teoful/ArduinoRightLight/Fritzing Schemes/Curtains.jpg

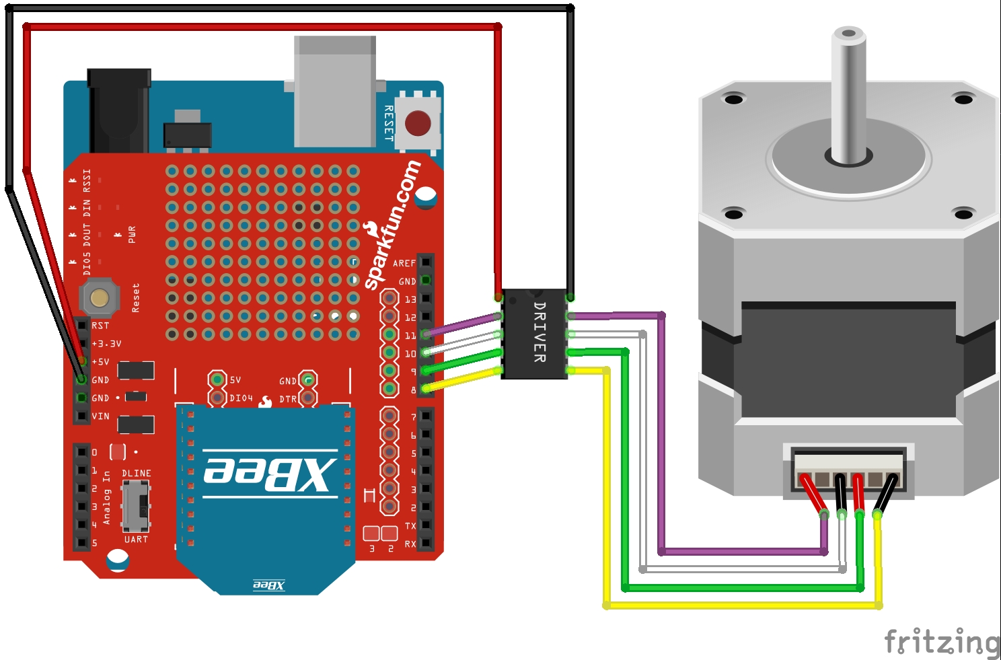
Fritzing Schemes/Curtains.jpg
