teoful/ArduinoRightLight/Fritzing Schemes/External.jpg

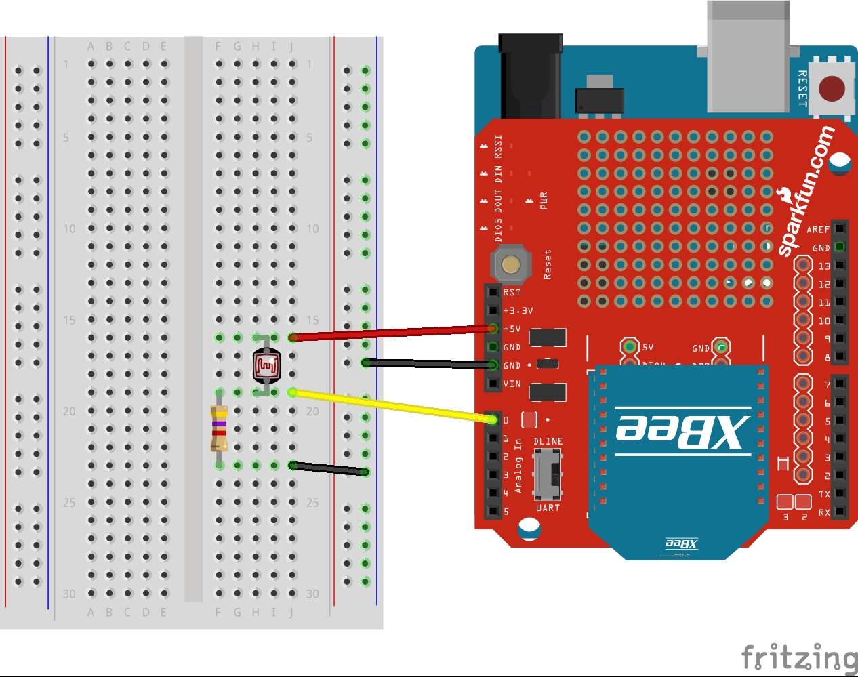
Fritzing Schemes/External.jpg
