teoful/ArduinoRightLight/Fritzing Schemes/Global.jpg

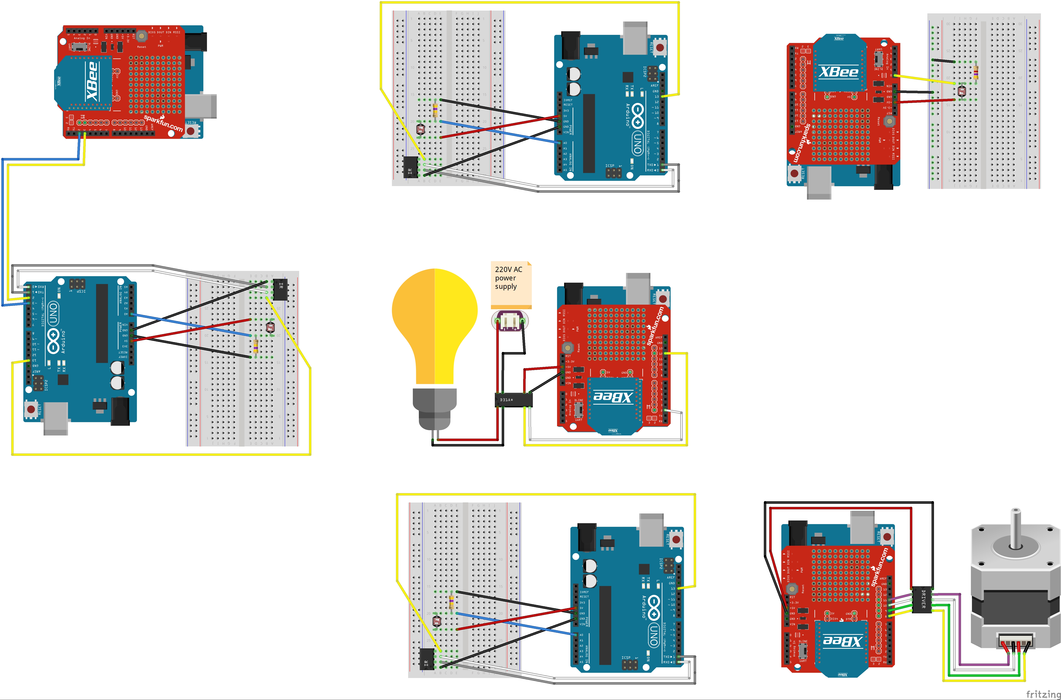
Fritzing Schemes/Global.jpg
