teoful/ArduinoRightLight/Fritzing Schemes/Internal.jpg

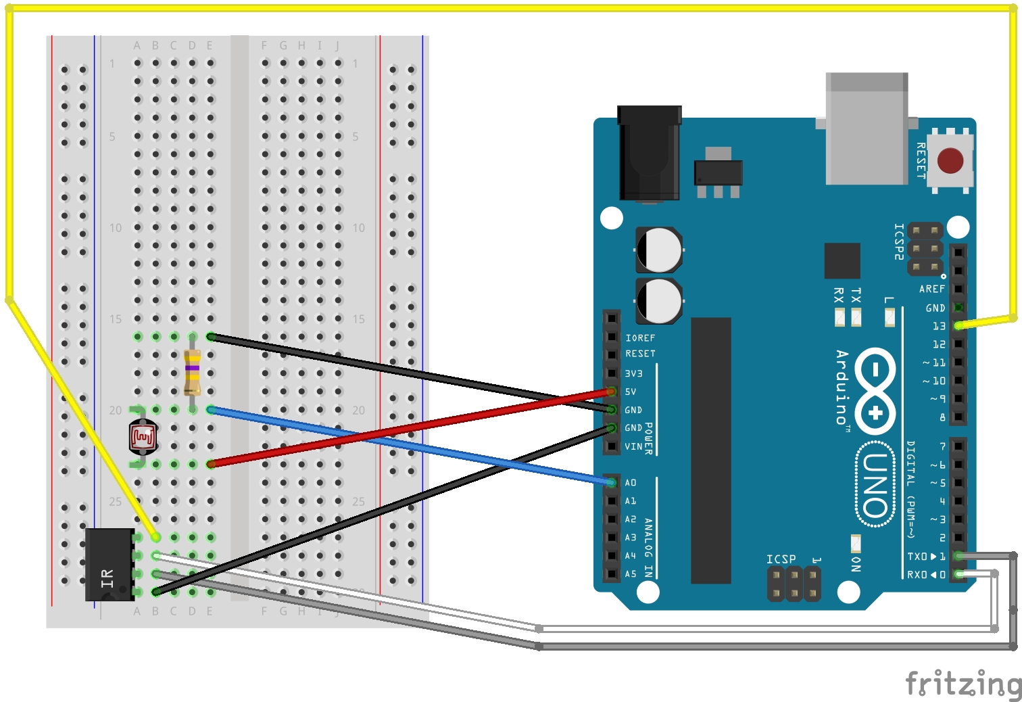
Fritzing Schemes/Internal.jpg
